ap0100/RC_car_prototype/design/rc_car_side_view.png

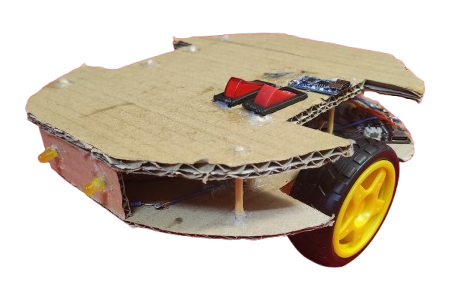
design/rc_car_side_view.png
