ap0100/RC_car_prototype/wiring_sketch.png

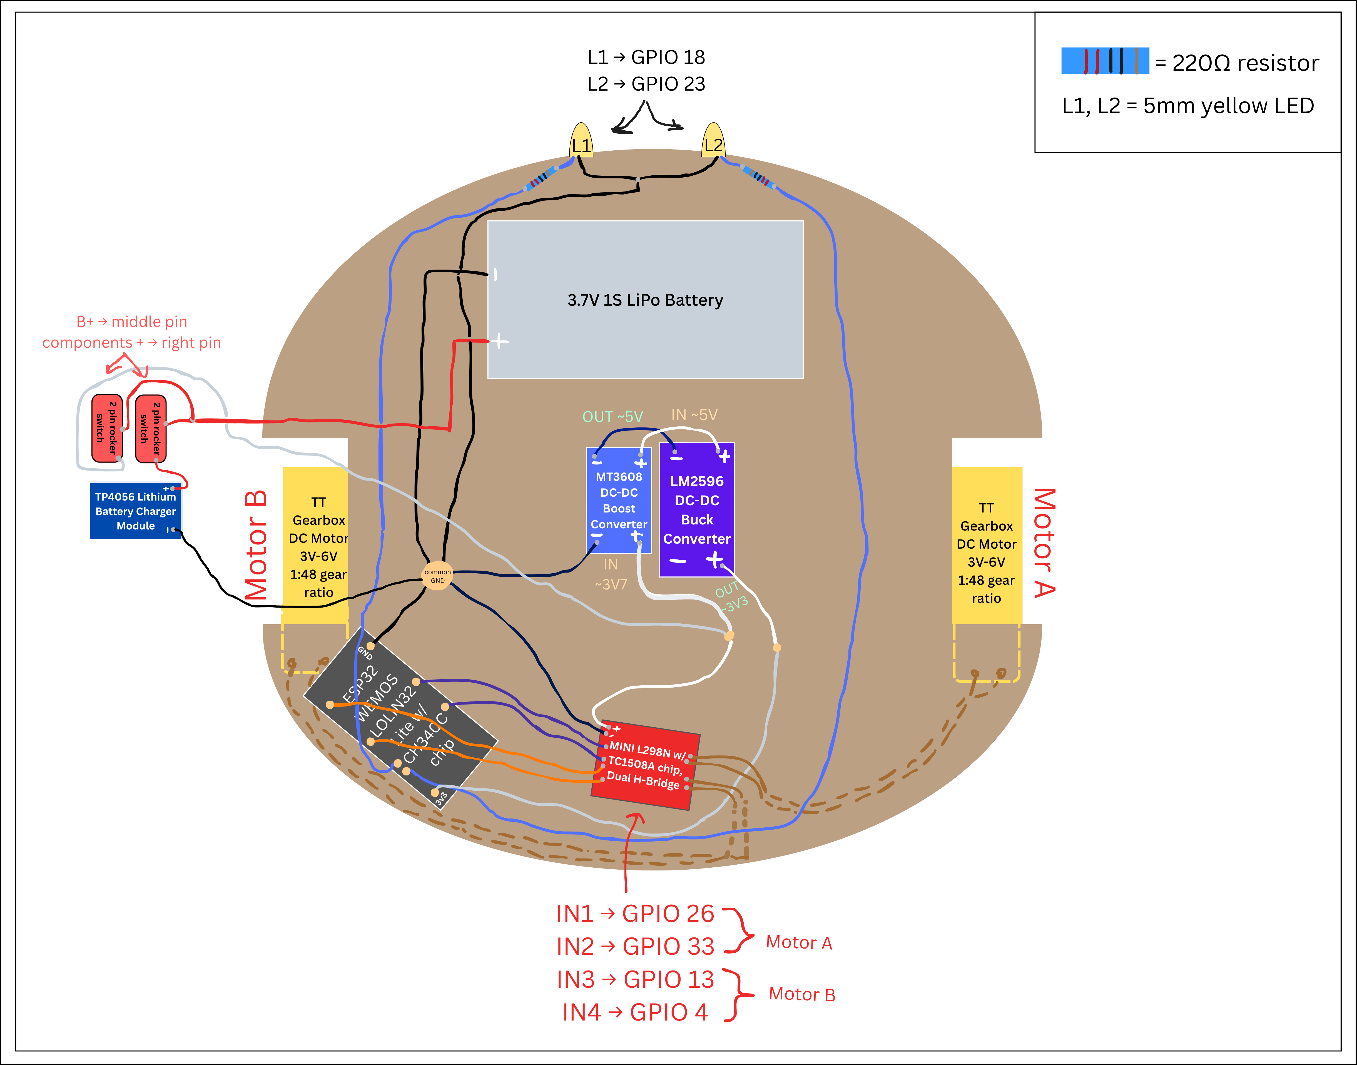
wiring_sketch.png
