ap0100/RC_car_prototype/(commit log)

2026-10-14 Revise README for ESP32 Web Bluetooth RC Car
    Updated project title and added detailed components, setup instructions, driving instructions, lessons learned, troubleshooting tips, and project status.
2026-10-22 Change control method from Web Bluetooth to Wi-Fi
    Updated the README to reflect the change from Web Bluetooth to Wi-Fi control for the ESP32 RC car. Revised connection instructions and troubleshooting sections.
2026-10-26 Revise README for ESP32 Wi-Fi RC Car 'Jerry'
    Updated project name to 'Jerry' and modified images.
